nektarios25ma/solar-tracker-azimuth-altitude-workSHOP/README.md

# solar-tracker-azimuth-altitude-workSHOP
