nektarios25ma/solar-tracker-azimuth-altitude-workSHOP/SOLAR TRACKER-ALTITUDE AND AZIMUTH SOLAR ANGLES.odp

## SOLAR TRACKER-ALTITUDE AND AZIMUTH SOLAR ANGLES

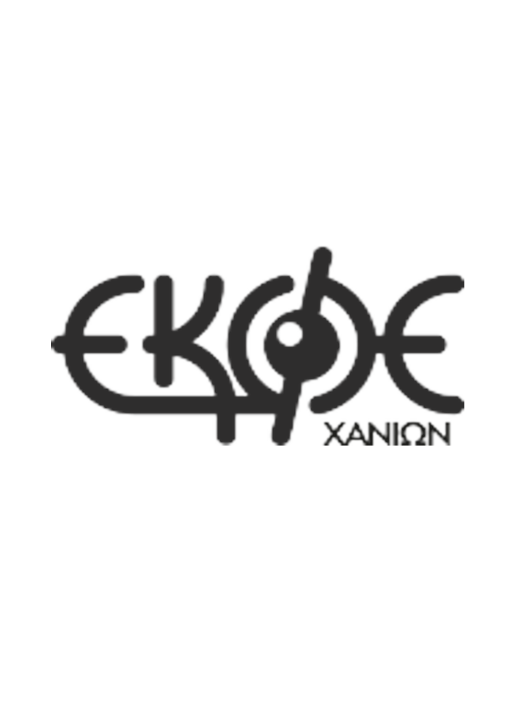
[picture p17: figure]

ΝΕΚΤΑΡΙΟΣ ΚΟΥΡΑΚΗΣ

ΝΙΚΟΣ ΑΝΑΣΤΑΣΑΚΗΣ

## Today's workshop has two objectives, to show that: 1) when turned at the right angle the photovoltaic panel has maximum energy efficiency 2) the recording of the angles formed by the sun in each place indirectly reveal the movement of the Earth around the Sun

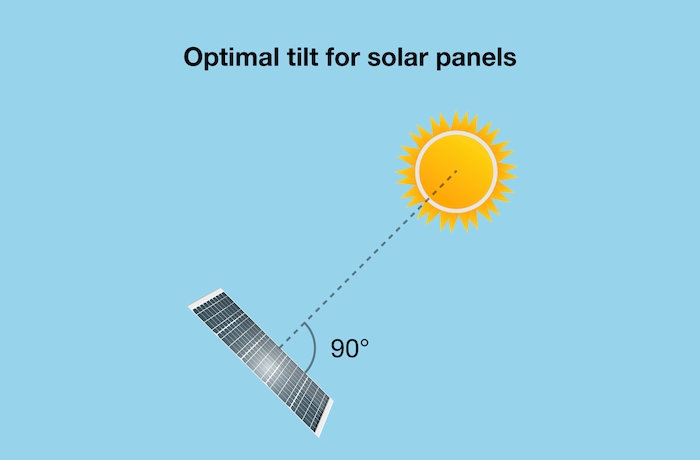
[picture p18: figure]
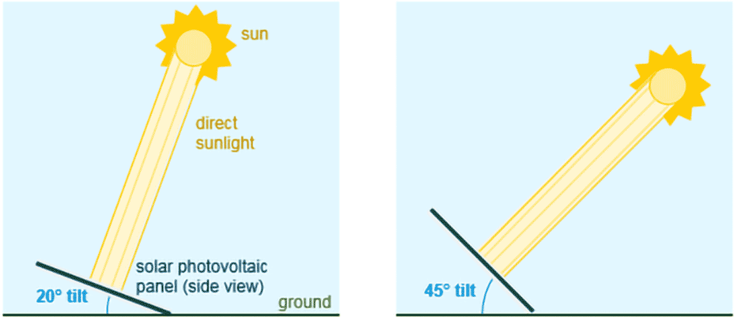
[picture p19: figure]
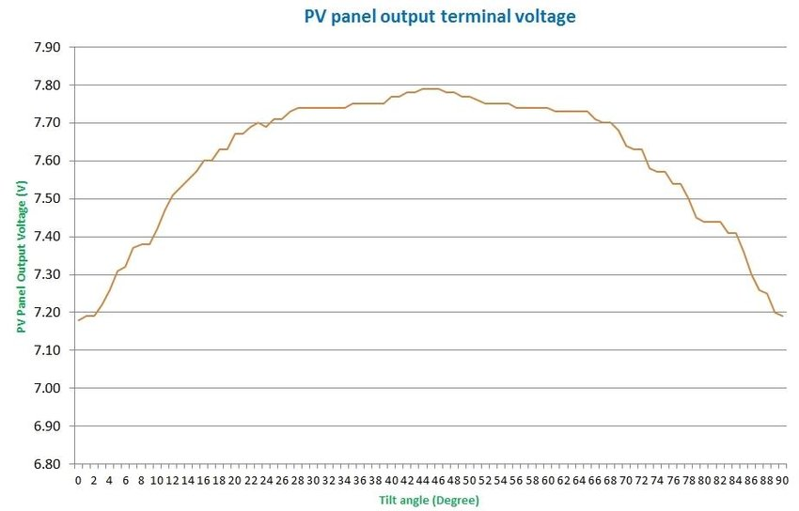
[picture p20: figure]

## The solar altitude (https://www.sciencedirect.com/topics/engineering/solar-altitude) angle is the angle between the sun’s rays and a horizontal plane.

Sun height (altitude)

The altitude of the sun refers to the angle that the sun forms with the horizon of the Earth. Since it is an angle, it is measured in degrees.

The slope is 0 ° at sunrise and sunset and can reach 90 ° (zenith) at noon, in places close to the equator.

Due to the inclination of the earth's axis of rotation, the position of the sun in the equatorial sky at noon will deviate during the year by +/- 23.5 degrees from the absolute vertical (zenith).

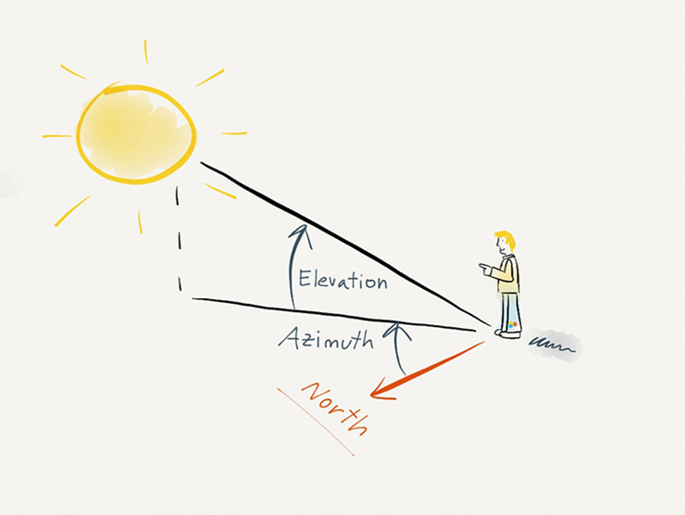
[picture p21: figure]

## SUN -AZIMUTH

There are two ways of determining the azimuth.The first is from geographic north to east and the second from south to east +angle see the picture above , - angle to the other direction.

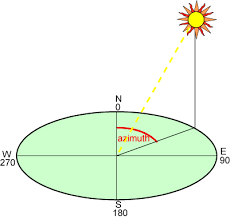
[picture p22: figure]
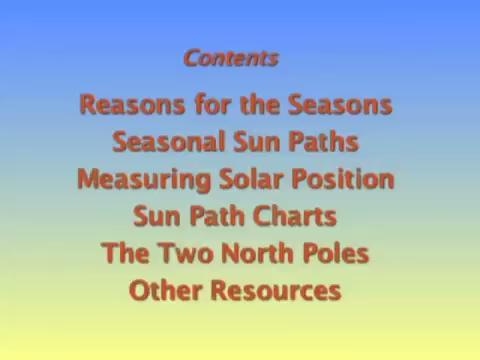
[picture p23: figure]

THANK YOU!
