nektarios25ma/solar-tracker-azimuth-altitude-workSHOP/SunPath (1).odp

## Βρίσκοντας το μονοπάτι του ήλιου

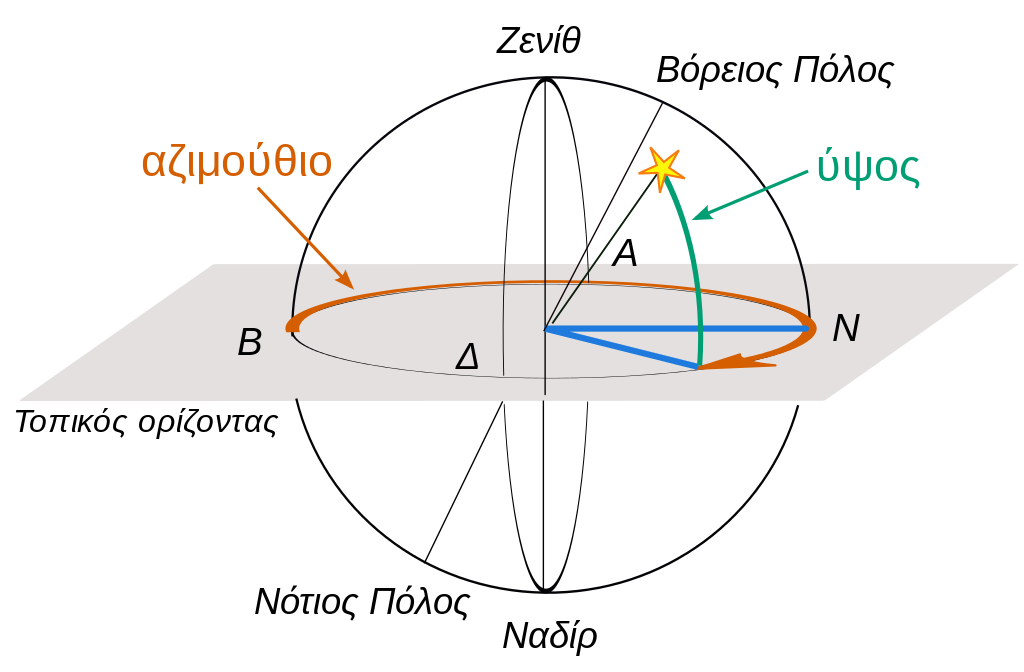
[picture p24: figure]

## Η διαδρομή του ήλιου

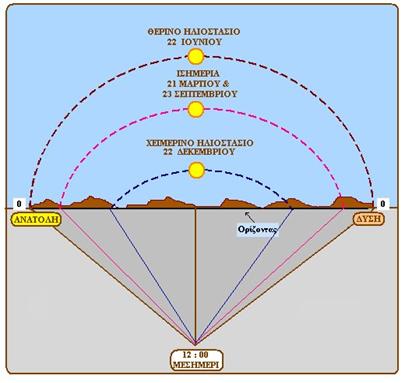
[picture p25: figure]

## Ύψος ήλιου (κλίση επιφάνειας) (altitude)

  Το ύψος του ήλιου αναφέρεται στη γωνία που σχηματίζει ο ήλιος με τον ορίζοντα της Γης. Αφού ειναι γωνία, μετριέται σε μήρες.
  Η κλίση είναι 0° στην ανατολή του ηλίου και στην δύση του και μπορεί να φτάσει τις 90° (ζενίθ) το μεσημέρι, σε μέρη κοντά στον ισημερινό.
  Λόγω της κλίσης του άξονα περιστροφής της γης η θέση του ήλιου στον ουρανό του ισημερινού το μεσημέρι θα αποκλίνει στη διάρκεια του έτους κατά +/- 23.5 μοίρες από το απολύτως κάθετο (ζενίθ).

## Slide 4

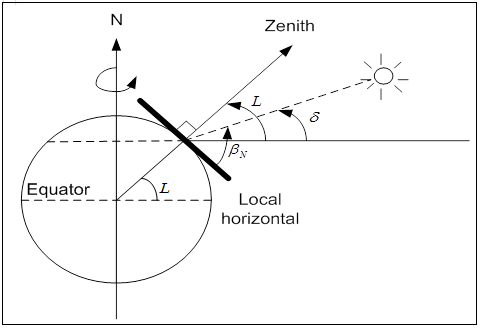
[picture p26: figure]

## Γωνία αζιμούθιου (azimuth)

  Είναι η γωνία προς την οποία ειναι στραμμένη μια επιφάνεια.
  Συνήθως μετριέται απο το Βορρά (0° / 360°) προς την Ανατολή.

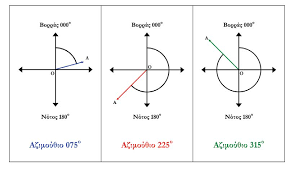
[picture p27: figure]

## Slide 6

  Ή μπορούμε ανάλογα το ημισφαίριο να το ορίσουμε διαφορετικά.
  Για τοποθεσίες του βόρειου ηµισφαιρίου µηδενική τιµή του αζιμούθιου γ αντιστοιχεί σε νότια κατεύθυνση, θετικές τιµές του αναφέρονται σε δυτικούς προσανατολισµούς, και αρνητικές τιµές του γ σε ανατολικούς προσανατολισµούς.

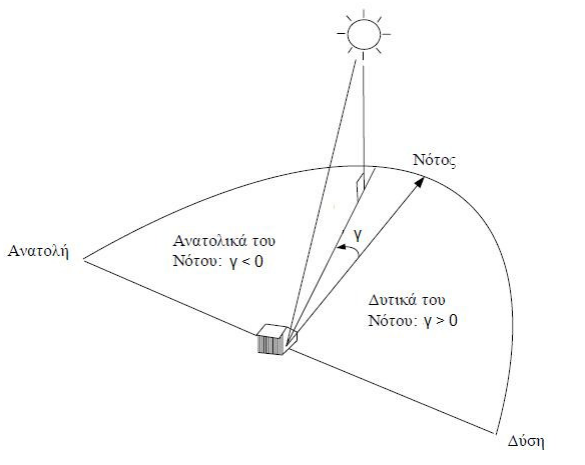
[picture p28: figure]

## Slide 7

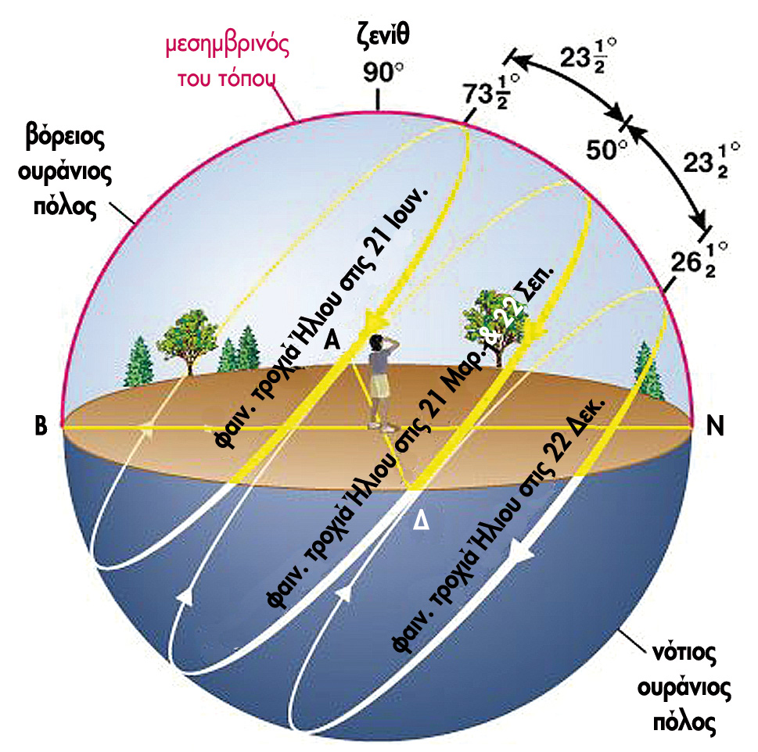
[picture p29: figure]

  Αθηνά Μαρία Αθανασάκη – ΓΕΛ Κισάμου

## ΠΗΓΕΣ

- Motions of the Sun simulator (https://ccnmtl.github.io/astro-simulations/sun-motion-simulator/)
- Sun Path (wikipedia) (https://en.wikipedia.org/wiki/Sun_path)
- Position of the Sun (wikipedia) (https://en.wikipedia.org/wiki/Position_of_the_Sun)
- Solar altitude (https://sciencing.com/solar-altitude-23364.html)
- Solar Zenith Angle (wikipedia) (https://en.wikipedia.org/wiki/Solar_zenith_angle)
- Solar Azimuth (wikipedia) (https://en.wikipedia.org/wiki/Solar_azimuth_angle)
- Διάγραμμα μονοπατιού (https://www.sunearthtools.com/dp/tools/pos_sun.php)
- Μονοπάτι του Ήλιου στην Αθήνα (https://acomelectronics.com/forum/viewtopic.php?t=20)
- Ηλιακή Ακτινοβολία - Γεωμετρία
